havandat1523/IoT-Monitoring-System-for-Primary-Students-on-School-Shuttle-Buses/Altium_design/PCB_node3_iot.png

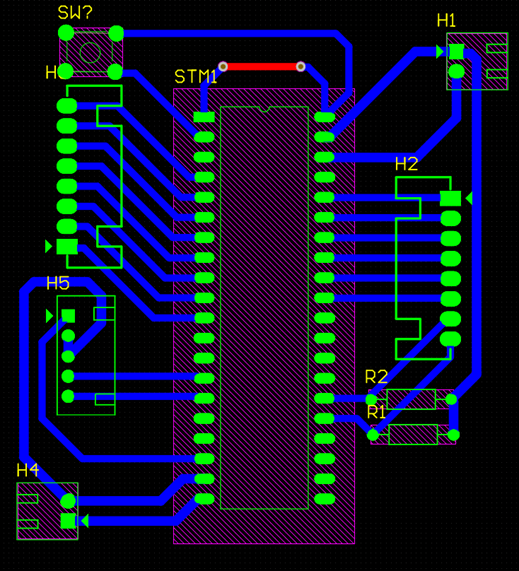
Altium_design/PCB_node3_iot.png
