havandat1523/IoT-Monitoring-System-for-Primary-Students-on-School-Shuttle-Buses/Altium_design/real_hardware_node3_iot.jpg

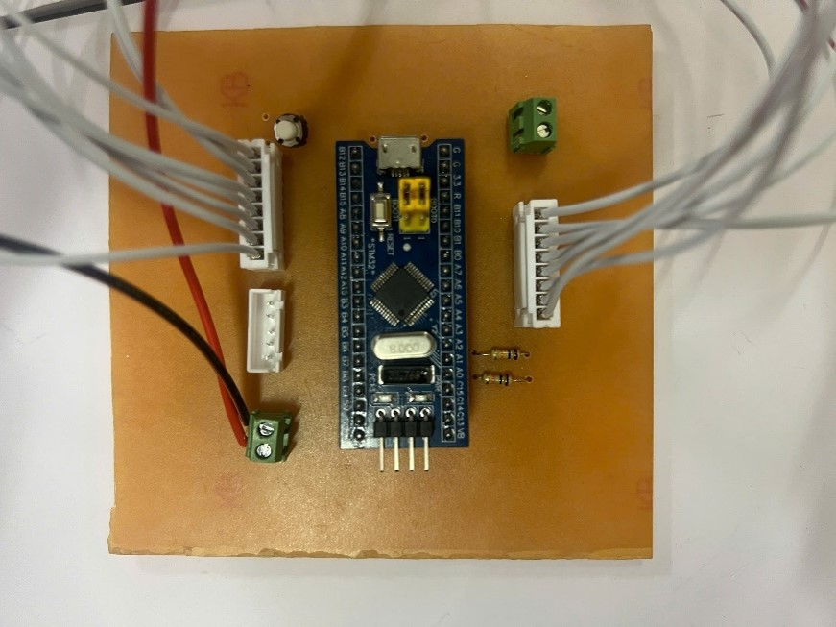
Altium_design/real_hardware_node3_iot.jpg
