havandat1523/IoT-Monitoring-System-for-Primary-Students-on-School-Shuttle-Buses/Altium_design/Schematic_node3_iot.png

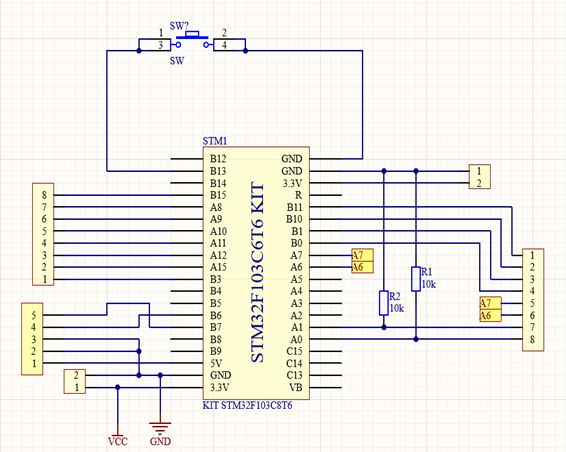
Altium_design/Schematic_node3_iot.png
