havandat1523/IoT-Monitoring-System-for-Primary-Students-on-School-Shuttle-Buses/CODE_App_Script/pictrure_1.png

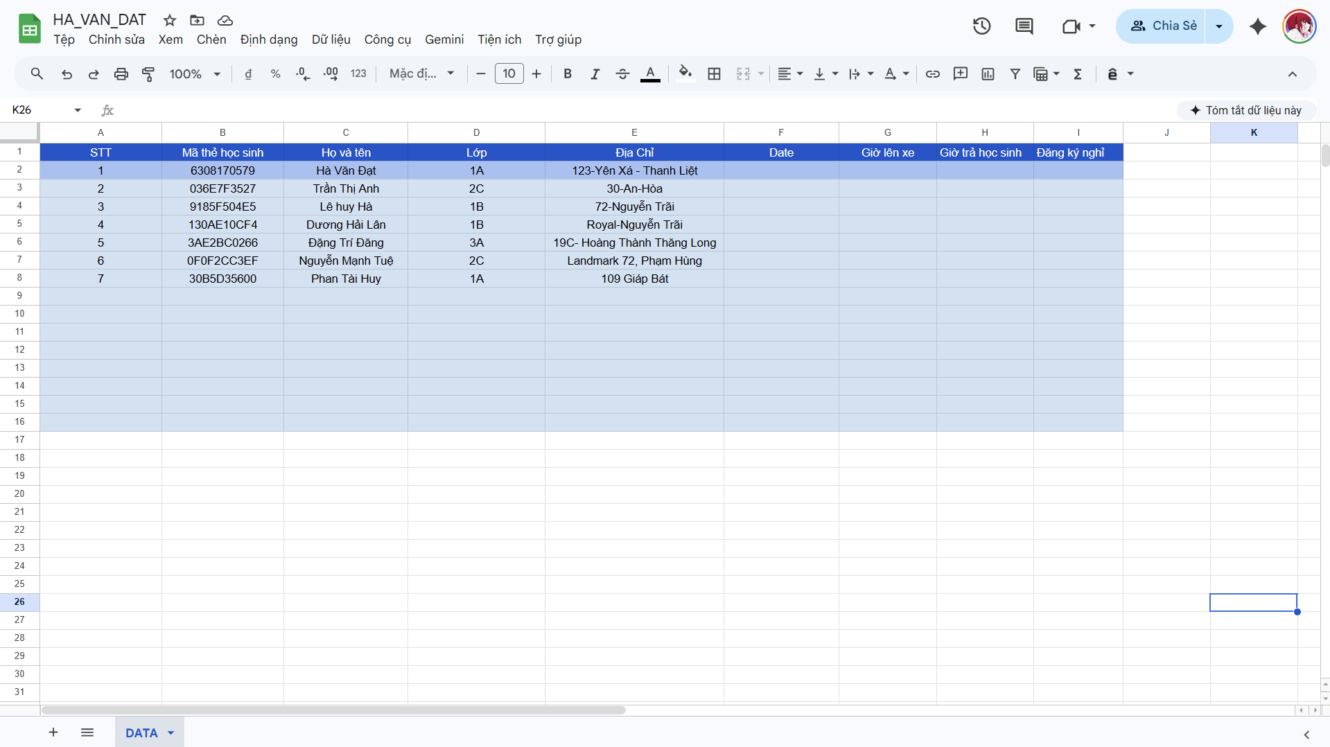
CODE_App_Script/pictrure_1.png
