havandat1523/IoT-Monitoring-System-for-Primary-Students-on-School-Shuttle-Buses/CODE_Thingsboard/3.png

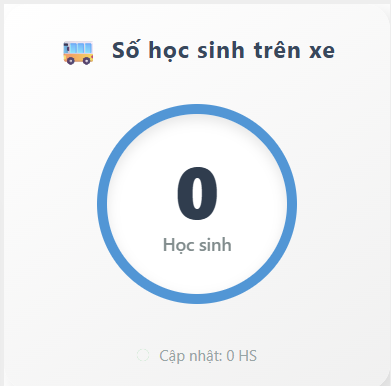
CODE_Thingsboard/3.png
