havandat1523/IoT-Monitoring-System-for-Primary-Students-on-School-Shuttle-Buses/CODE_Thingsboard/Ảnh chụp màn hình 2026-05-09 223746.png

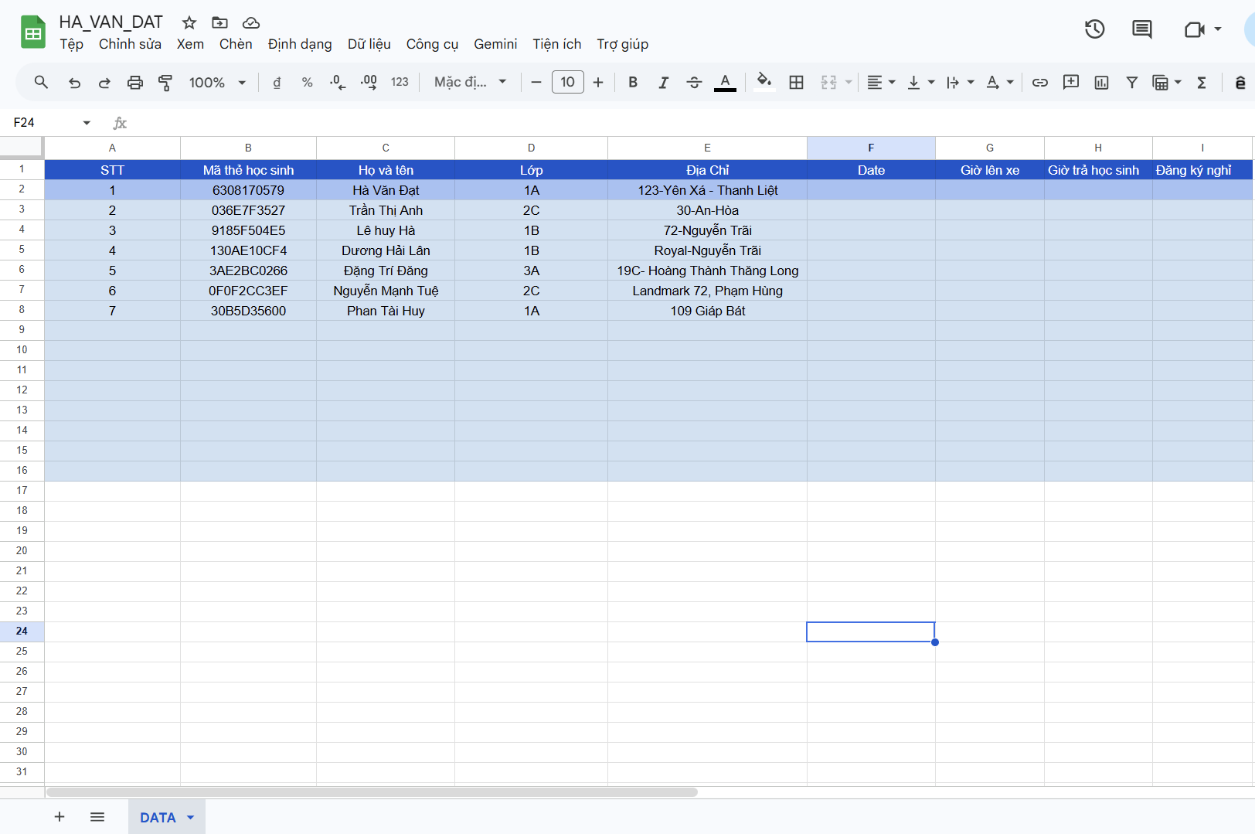
CODE_Thingsboard/Ảnh chụp màn hình 2026-05-09 223746.png
