havandat1523/IoT-Monitoring-System-for-Primary-Students-on-School-Shuttle-Buses/Altium_design/MASTER.pdf

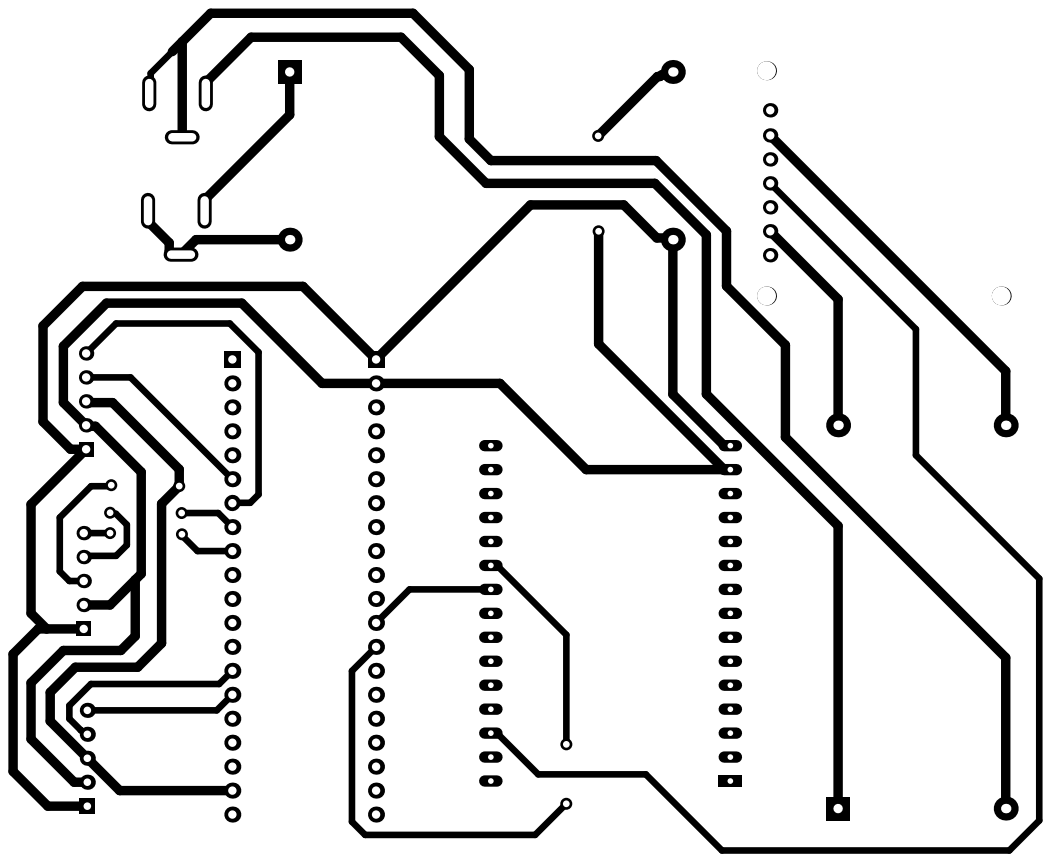
[picture p58: page 1]
