havandat1523/IoT-Monitoring-System-for-Primary-Students-on-School-Shuttle-Buses/Altium_design/NODE1_IOT.pdf

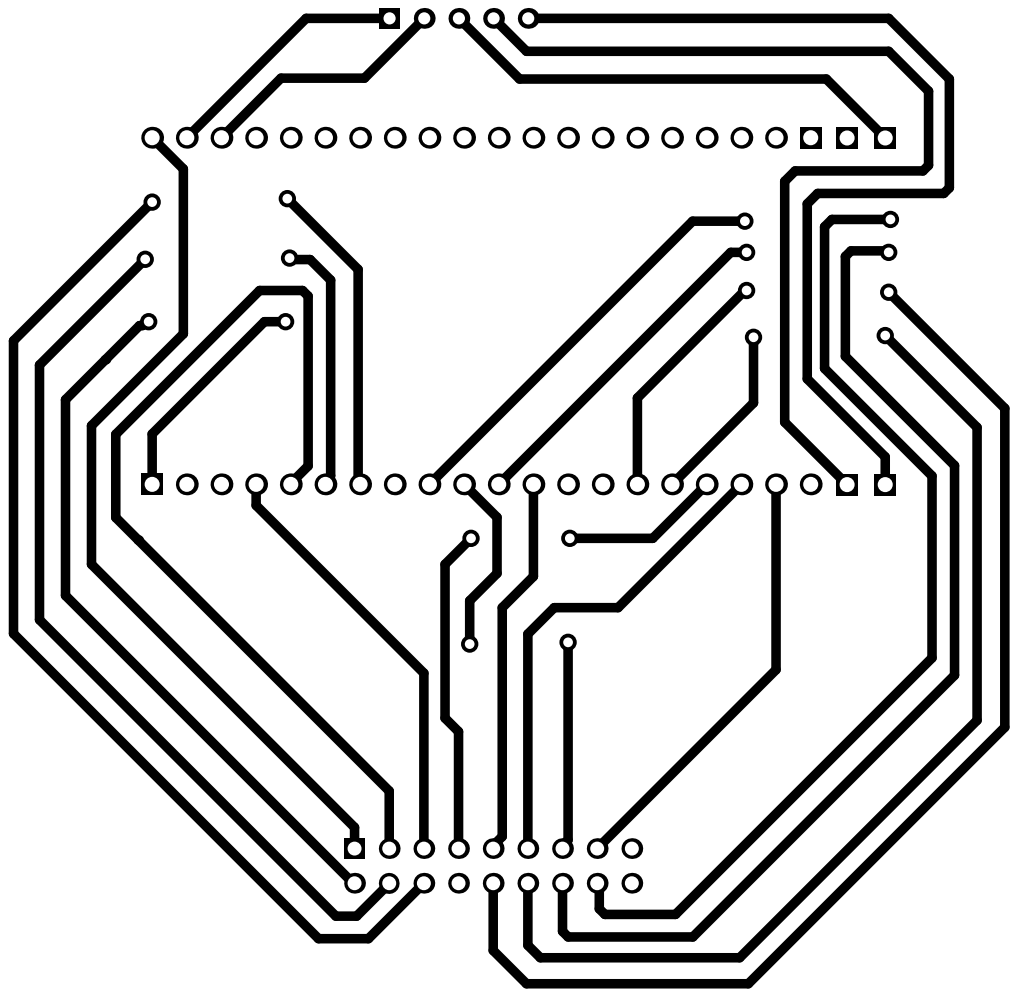
[picture p59: page 1]
