havandat1523/IoT-Monitoring-System-for-Primary-Students-on-School-Shuttle-Buses/Altium_design/NODE2_IOT.pdf

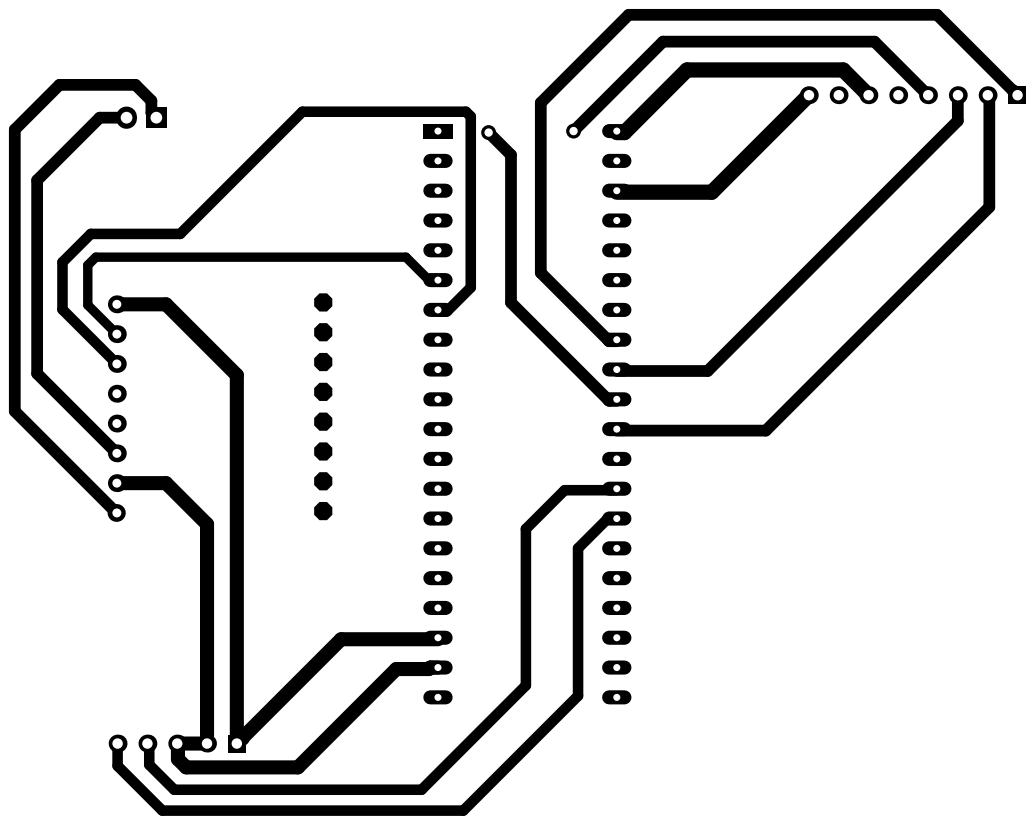
[picture p60: page 1]
