havandat1523/IoT-Monitoring-System-for-Primary-Students-on-School-Shuttle-Buses/Altium_design/NODE3_IOT.pdf

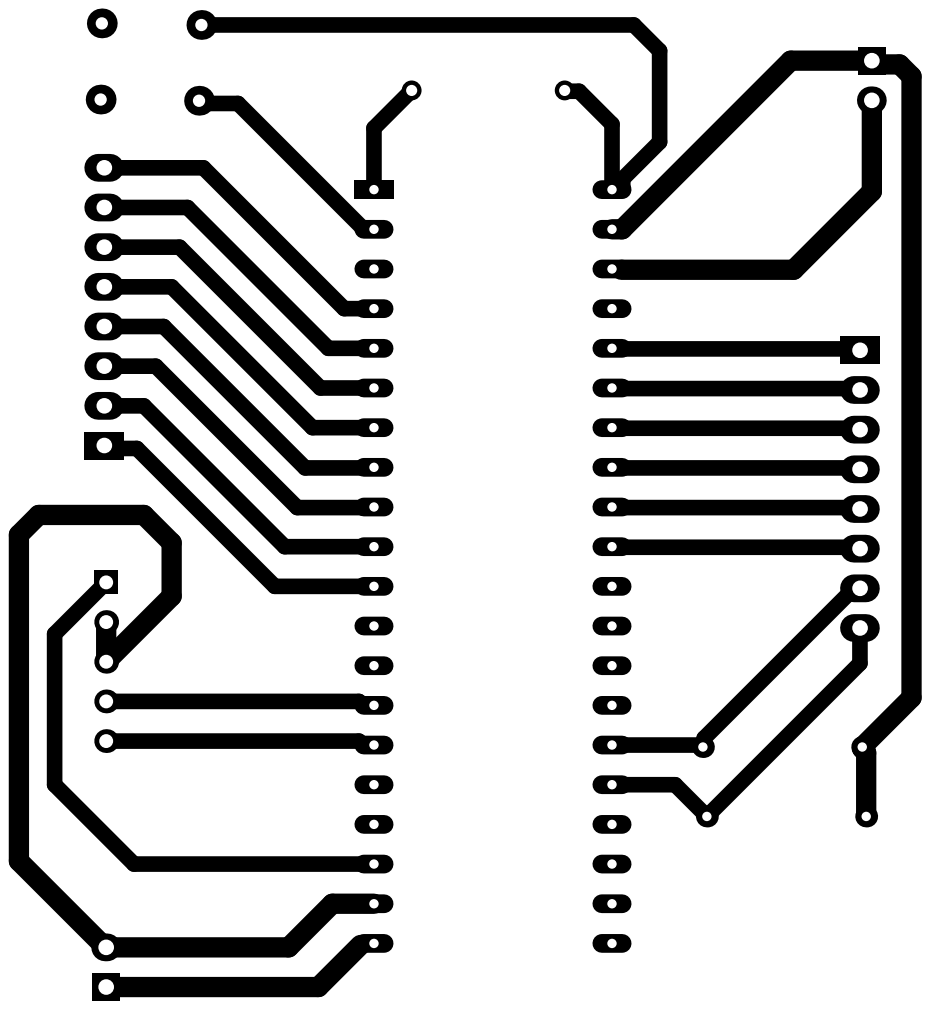
[picture p61: page 1]
