havandat1523/IoT-Monitoring-System-for-Primary-Students-on-School-Shuttle-Buses/CODE_NODE3/Core/Src/main.c

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
/* Includes ------------------------------------------------------------------*/
#include "main.h"

I2C_HandleTypeDef hi2c1;

TIM_HandleTypeDef htim2;

void SystemClock_Config(void);
static void MX_GPIO_Init(void);
static void MX_I2C1_Init(void);
static void MX_TIM2_Init(void);
/* USER CODE BEGIN 0 */
#define F411_I2C_ADDR  (0x20<<1) // Bắt buộc phải dịch trái 1 bit
/* USER CODE BEGIN 0 */
uint8_t int_Tem   = 0 ;
uint8_t float_Tem = 0 ;
uint8_t int_Hum   = 0 ;
uint8_t float_Hum = 0 ;
uint8_t CheckSum  = 0 ;


typedef struct {
    uint8_t physical_state;
    uint8_t confirmed_state;
    uint32_t last_time;
    uint8_t zero_count; // ← THÊM BỘ ĐẾM SỐ LẦN LIÊN TIẾP ĐỌC = 0
} Seat_t;

Seat_t seats[15]; // Mảng quản lý 14 cái ghế (12 nút nhấn + 2 ADC)
uint8_t flag_send_i2c = 0;   // Cờ báo hiệu cần gửi data lên F411
uint16_t all_seats_data = 0; // Biến 2 byte gom trạng thái các ghế

typedef struct {
    GPIO_TypeDef* port;
    uint16_t pin;
} Seat_Pin_Map_t;

// Đã đếm chuẩn 12 phần tử (Từ index 0 đến 11)
const Seat_Pin_Map_t SeatPins[15] = {
		{GPIOB,GPIO_PIN_11},//5 0
		{GPIOB,GPIO_PIN_1},  //1
		{GPIOB,GPIO_PIN_10},//0  2
		{GPIOB,GPIO_PIN_0},//7   3
		{GPIOA,GPIO_PIN_7},//9  4
		{GPIOA,GPIO_PIN_6},//8  5
		{GPIOA,GPIO_PIN_1},//11  6
		{GPIOA,GPIO_PIN_0},//10  7
		{GPIOB,GPIO_PIN_15},  //8
		{GPIOA,GPIO_PIN_8},//1  //9
		{GPIOA,GPIO_PIN_9},//2  10
		{GPIOA,GPIO_PIN_10},//4  11
		{GPIOC,GPIO_PIN_13},//12   12
		{GPIOC,GPIO_PIN_13},      //13
		{GPIOC,GPIO_PIN_13},//4  14


//		{GPIOB,GPIO_PIN_10},//0
//		{GPIOA,GPIO_PIN_8},//1
//		{GPIOA,GPIO_PIN_9},//2
//		{GPIOA,GPIO_PIN_10},//3
//		{GPIOA,GPIO_PIN_11},//4
//		//{GPIOA,GPIO_PIN_12},//5
//
//		//{GPIOB,GPIO_PIN_3},//7
//		{GPIOB,GPIO_PIN_13},//6
//		{GPIOB,GPIO_PIN_0},//7
//		{GPIOA,GPIO_PIN_6},//8
//		{GPIOA,GPIO_PIN_7},//9
//		{GPIOA,GPIO_PIN_0},//10
//		{GPIOA,GPIO_PIN_1},//11
//		{GPIOA,GPIO_PIN_15},//12
};

uint8_t Read_Seat_Hardware(uint8_t index) {
    // Chỉ đọc GPIO cho 12 ghế đầu tiên để tránh tràn mảng SeatPins
    if (index < 15) {
    	GPIO_TypeDef* current_port = SeatPins[index].port;
    	uint16_t current_pin = SeatPins[index].pin;
    	if (HAL_GPIO_ReadPin(current_port, current_pin) == GPIO_PIN_SET){
    		HAL_Delay(50);
    		return 1;
    	}
    	else if (HAL_GPIO_ReadPin(current_port, current_pin) == 0){
    		HAL_Delay(50);
    		return 0;
    	}
    }
    return 0;
}

//void Scan_All_Seats(void) {
//    // Quét đúng 15 ghế
//    for (int i = 0; i < 15; i++) {
//        uint8_t current_sensor = Read_Seat_Hardware(i);
//
//        if (current_sensor != seats[i].physical_state) {
//            // Trạng thái vật lý thay đổi -> cập nhật và reset mốc thời gian
//            seats[i].physical_state = current_sensor;
//            seats[i].last_time = HAL_GetTick();
//        }
//        else {
//            // Trạng thái vật lý đang giữ nguyên liên tục
//            uint32_t delay_thoi_gian;
//
//            // --- THIẾT LẬP THỜI GIAN CHỜ BẤT ĐỐI XỨNG ---
//            if (current_sensor == 1) {
//                // Người mới ngồi xuống: Chỉ cần giữ 0.5 giây là xác nhận có người
//                delay_thoi_gian = 1000;
//            } else {
//                // Người đứng lên (hoặc cảm biến tự ngắt): Chờ hẳn 3 giây mới xác nhận ghế trống
//                // Nếu trong 3 giây này tín hiệu bật lại mức 1, nó sẽ reset lại quá trình đếm
//                delay_thoi_gian = 30000;
//            }
//
//            // Nếu giữ trạng thái đủ thời gian yêu cầu
//            if (HAL_GetTick() - seats[i].last_time >= delay_thoi_gian) {
//
//                if (seats[i].confirmed_state != seats[i].physical_state) {
//                    seats[i].confirmed_state = seats[i].physical_state;
//
//                    if (seats[i].confirmed_state == 1) {
//                        all_seats_data |= (1 << i);  // Set bit lên 1 (Có người)
//                    } else {
//                        all_seats_data &= ~(1 << i); // Xóa bit về 0 (Trống)
//                    }
//
//                    flag_send_i2c = 1; // Bật cờ gửi data lên F4
//                }
//            }
//        }
//    }
//}
void Scan_All_Seats(void) {
    for (int i = 0; i < 15; i++) {
        uint8_t current_sensor = Read_Seat_Hardware(i);

        if (current_sensor != seats[i].physical_state) {
            // Trạng thái thay đổi → lưu lại và bắt đầu đếm 3 giây
            seats[i].physical_state = current_sensor;
            seats[i].last_time = HAL_GetTick();
        }
        else {
            // Giữ nguyên trạng thái → kiểm tra đủ 3 giây chưa
            if (HAL_GetTick() - seats[i].last_time >= 1000) {

                if (current_sensor == 1) {
                    // Giữ mức 1 đủ 3s → xác nhận có người
                    if (seats[i].confirmed_state != 1) {
                        seats[i].confirmed_state = 1;
                        all_seats_data |= (1 << i);
                        flag_send_i2c = 1;
                    }
                }
                else {
                    // Giữ mức 0 đủ 3s → xác nhận ghế trống
                    if (seats[i].confirmed_state != 0) {
                        seats[i].confirmed_state = 0;
                        all_seats_data &= ~(1 << i);
                        flag_send_i2c = 1;
                    }
                }
            }
        }
    }
}

uint8_t tx_buffer[4];
void xu_ly(uint16_t giatri){
	 // Tăng lên 3 byte
	tx_buffer[0] = 0x01;  // Gắn nhãn ID = 0x01 (Dữ liệu ghế)
	tx_buffer[1] = (giatri >> 8) & 0xFF; // Lấy byte cao
	tx_buffer[2] = giatri & 0xFF;        // Lấy byte thấp
	tx_buffer[3]= 0x09;
}
uint32_t doc = 0;
uint8_t trang_thai_cu = 1; // Trạng thái trước đó (mặc định nhả = 1)

void am_thanh(void) {
    uint8_t trang_thai_hien = HAL_GPIO_ReadPin(GPIOB, GPIO_PIN_13);

    // Phát hiện nhấn xuống (cạnh xuống: 1 → 0)
    if (trang_thai_hien == 0 && trang_thai_cu == 1) {
        doc = HAL_GetTick(); // Lưu thời điểm bắt đầu nhấn
    }

    // Kiểm tra giữ đủ 1 giây
    if (trang_thai_hien == 0 && (HAL_GetTick() - doc >= 500)) {
        // Xử lý ở đây
    	HAL_GPIO_TogglePin(GPIOB, GPIO_PIN_12);
        doc = HAL_GetTick(); // Reset để không gọi liên tục
    }

    trang_thai_cu = trang_thai_hien;
}
//uint8_t data = 23;
/* USER CODE END 0 */

/**
  * @brief  The application entry point.
  * @retval int
  */
int main(void)
{

  /* MCU Configuration--------------------------------------------------------*/

  /* Reset of all peripherals, Initializes the Flash interface and the Systick. */
  HAL_Init();

  /* Configure the system clock */
  SystemClock_Config();

  /* Initialize all configured peripherals */
  MX_GPIO_Init();
  MX_I2C1_Init();
  MX_TIM2_Init();
  /* USER CODE BEGIN 2 */
//  HAL_I2C_Master_Transmit(&hi2c1,(0x20<<1), &data, 1, 100);
  HAL_Delay(1000);
  HAL_StatusTypeDef trangthai;
  /* USER CODE END 2 */

  /* Infinite loop */
  /* USER CODE BEGIN WHILE */
  while (1)
  {
	 // HAL_Delay(2000);
    Scan_All_Seats();
    if (flag_send_i2c==1){

    	xu_ly(all_seats_data);
    	//HAL_Delay(20);
			trangthai = HAL_I2C_Master_Transmit(&hi2c1, F411_I2C_ADDR,(uint8_t*) &tx_buffer[0], 1, 1000);
			HAL_Delay(200);
			trangthai = HAL_I2C_Master_Transmit(&hi2c1, F411_I2C_ADDR,(uint8_t*) &tx_buffer[1], 1, 1000);
			HAL_Delay(200);
			trangthai = HAL_I2C_Master_Transmit(&hi2c1, F411_I2C_ADDR,(uint8_t*) &tx_buffer[2], 1, 1000);
			HAL_Delay(200);
			trangthai = HAL_I2C_Master_Transmit(&hi2c1, F411_I2C_ADDR,(uint8_t*) &tx_buffer[3], 1, 1000);
			flag_send_i2c =0;
    }
      am_thanh();

     	 HAL_Delay(200);


    /* USER CODE END WHILE */

    /* USER CODE BEGIN 3 */
  }
  /* USER CODE END 3 */
}

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
