havandat1523/IoT-Monitoring-System-for-Primary-Students-on-School-Shuttle-Buses/CODE_NODE_MASTER/STM32M/STM32M.ioc

Mcu.UserName=STM32F411CEUx
PA10.Signal=USART1_RX
PA11.Signal=USART6_TX
PA12.Signal=USART6_RX
PA13.Signal=SYS_JTMS-SWDIO
PA14.Signal=SYS_JTCK-SWCLK
PA2.Signal=USART2_TX
PA3.Signal=USART2_RX
PA9.Signal=USART1_TX
PB6.Signal=I2C1_SCL
PB7.Signal=I2C1_SDA
