havandat1523/IoT-Monitoring-System-for-Primary-Students-on-School-Shuttle-Buses/CODE_NODE2/Core/Src/main.c

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
/* Includes ------------------------------------------------------------------*/
#include "main.h"

/* USER CODE BEGIN Includes */
#include "RC522.h"
#include "DFPLAYER.h"
#include <string.h>
#include <stdio.h>

/* USER CODE END Includes */

/* USER CODE BEGIN PTD */
DFPLAYER_Name MP3;


/* USER CODE END PTD */

/* USER CODE BEGIN PD */
uint8_t u8_RxBuff1[50];  // Buffer cho UART1 (Camera)
uint8_t u8_RxBuff2[50];  // Buffer cho UART2 (ESP32)
uint8_t u8_RxBuff3[50];  // loa

uint8_t u8_RxData1;      // Byte nh?n c?a esp
uint8_t u8_RxData2;      // Byte nh?n c?a Camera
uint8_t u8_RxData3;      // Byte nhan cua loa

uint8_t _rxIndex1 = 0;   // Index cho UART1
uint8_t _rxIndex2 = 0;   // Index cho UART2
uint8_t _rxIndex3 = 0;   // Index cho UART3

volatile uint8_t Tx_Flag1 = 0; 
volatile uint8_t Tx_Flag2 = 0; 
volatile uint8_t Tx_Flag3 = 0;
/* USER CODE END PD */

SPI_HandleTypeDef hspi1;

UART_HandleTypeDef huart1;
UART_HandleTypeDef huart2;

/* USER CODE BEGIN PV */
uint8_t CardID[5];
uint8_t rx_data[3];
char tx_buffer[50];
//uint8_t ngat =0;

/* USER CODE END PV */

void SystemClock_Config(void);
static void MX_GPIO_Init(void);
static void MX_SPI1_Init(void);
static void MX_USART1_UART_Init(void);
static void MX_USART2_UART_Init(void);
/* USER CODE BEGIN 0 */
volatile uint8_t ngat = 0;

void HAL_UART_RxCpltCallback(UART_HandleTypeDef *huart)
{
    if(huart->Instance == USART2)
    {
        // Kiểm tra xem ký tự nhận được có phải là ký tự kết thúc (\r hoặc \n) không
        if(u8_RxData1 != '\r' && u8_RxData1 != '\n')
        {
            u8_RxBuff2[_rxIndex2++] = u8_RxData1; // Lưu vào buffer UART2
            if(_rxIndex2 >= sizeof(u8_RxBuff2) - 1) {
                _rxIndex2 = sizeof(u8_RxBuff2) - 1; // Chống tràn mảng
            }
        }
        else
        {
            if(_rxIndex2 > 0)
            {
                u8_RxBuff2[_rxIndex2] = '\0'; // Kết thúc chuỗi
                Tx_Flag2 = 1;                 // SỬA Ở ĐÂY: Set cờ UART2
            }
        }
        // Gọi lại ngắt nhận 1 byte tiếp theo
        HAL_UART_Receive_IT(&huart2, &u8_RxData1, 1);
    }
}
/* USER CODE END 0 */

/**
  * @brief  The application entry point.
  * @retval int
  */
int main(void)
{

  /* MCU Configuration--------------------------------------------------------*/

  /* Reset of all peripherals, Initializes the Flash interface and the Systick. */
  HAL_Init();

  /* Configure the system clock */
  SystemClock_Config();

  /* Initialize all configured peripherals */
  MX_GPIO_Init();
  MX_SPI1_Init();
  MX_USART1_UART_Init();
  MX_USART2_UART_Init();
  /* USER CODE BEGIN 2 */
	  TM_MFRC522_Init();
  DFPLAYER_Init(&MP3, &huart1);
  DFPLAYER_SetVolume(&MP3, 5);
	HAL_Delay(2000);
	DFPLAYER_PlayFileInFolder(&MP3, 02, 002);
  HAL_UART_Receive_IT(&huart2, &u8_RxData1, 1); 
  /* USER CODE END 2 */

  /* Infinite loop */
  /* USER CODE BEGIN WHILE */
  while (1)
  {
    /* USER CODE END WHILE */
   if (TM_MFRC522_Check(CardID) == MI_OK) {

              sprintf(tx_buffer, "%02X%02X%02X%02X%02X\r\n",
                      CardID[0], CardID[1], CardID[2], CardID[3], CardID[4]);
              HAL_UART_Transmit(&huart2, (uint8_t*)tx_buffer, strlen(tx_buffer), 1000);
              HAL_Delay(500);
      }
	    // XỬ LÝ NHẬN LỆNH TỪ UART2 ESP/MẠCH KHÁC
      if(Tx_Flag2 == 1)
      {
          // Dùng strcmp để so sánh toàn bộ chuỗi cho chính xác, thay vì so sánh từng ký tự
          if(strcmp((char*)u8_RxBuff2, "003") == 0) {
						// Nhận "003" thì phát loa bài 3 trong folder 3: h?c sinh cuoi cung da len xe bac tai có the di xe ve truong
              DFPLAYER_PlayFileInFolder(&MP3, 03, 003);
          }
          else if(strcmp((char*)u8_RxBuff2, "004") == 0) {
              // Nhận "004" thì phát loa bài 4 trong folder 4
              DFPLAYER_PlayFileInFolder(&MP3, 04, 004);
          }
					 
          else if(strcmp((char*)u8_RxBuff2, "001") == 0) {
              // hs dã xu?ng het xe bac tai kiem tra lai
              DFPLAYER_PlayFileInFolder(&MP3, 01, 001);
          }
					 else if(strcmp((char*)u8_RxBuff2, "005") == 0) {
              // Nhận "001" thì phát loa bài 01 trong folder 001
              DFPLAYER_PlayFileInFolder(&MP3, 05, 005);
          }
					 else if(strcmp((char*)u8_RxBuff2, "002") == 0) {
						 // Nhận "002" thì phát loa bài 002 trong folder 02: b?t dau khoi hanh
              DFPLAYER_PlayFileInFolder(&MP3, 02, 002);
          }
          
          // QUAN TRỌNG: Xóa cờ, reset Index và xóa bộ đệm để chờ nhận lệnh tiếp theo
          Tx_Flag2 = 0;
          _rxIndex2 = 0;
          memset(u8_RxBuff2, 0, sizeof(u8_RxBuff2));
      }

	 

    /* USER CODE BEGIN 3 */
  }
  /* USER CODE END 3 */
}

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
