havandat1523/IoT-Monitoring-System-for-Primary-Students-on-School-Shuttle-Buses/CODE_NODE2/Core/Src/RC522.c

/*
 * RC522.c
 *
 *  Created on: Mar 25, 2026
 *      Author: lanng
 */
#include "RC522.h"

// Gọi ra biến hspi2 đã được khởi tạo bên trong file main.c
extern SPI_HandleTypeDef hspi1;

// --- HÀM GIAO TIẾP SPI LÕI (Sử dụng HAL) ---
uint8_t TM_SPI_Send(uint8_t data) {
    uint8_t rx_data = 0;
    // Truyền 1 byte và nhận về 1 byte qua SPI2, timeout 100ms
    HAL_SPI_TransmitReceive(&hspi1, &data, &rx_data, 1, 100);
    return rx_data;
}

// --- QUẢN LÝ CHÂN CHIP SELECT (Software NSS) ---
void MFRC522_CS_LOW(void) {
	HAL_GPIO_WritePin(GPIOB, GPIO_PIN_0, GPIO_PIN_RESET);
}

void MFRC522_CS_HIGH(void) {
	HAL_GPIO_WritePin(GPIOB, GPIO_PIN_0, GPIO_PIN_SET);
}

// ==========================================================
// CÁC HÀM XỬ LÝ LOGIC CỦA RC522 (Giữ nguyên thuật toán gốc)
// ==========================================================

void TM_MFRC522_Init(void) {
	MFRC522_CS_HIGH(); // Đảm bảo CS ở mức cao trước khi bắt đầu

	TM_MFRC522_Reset();

	TM_MFRC522_WriteRegister(MFRC522_REG_T_MODE, 0x8D);
	TM_MFRC522_WriteRegister(MFRC522_REG_T_PRESCALER, 0x3E);
	TM_MFRC522_WriteRegister(MFRC522_REG_T_RELOAD_L, 30);
	TM_MFRC522_WriteRegister(MFRC522_REG_T_RELOAD_H, 0);

	/* 48dB gain */
	TM_MFRC522_WriteRegister(MFRC522_REG_RF_CFG, 0x70);

	TM_MFRC522_WriteRegister(MFRC522_REG_TX_AUTO, 0x40);
	TM_MFRC522_WriteRegister(MFRC522_REG_MODE, 0x3D);

	TM_MFRC522_AntennaOn();		//Open the antenna
}

TM_MFRC522_Status_t TM_MFRC522_Check(uint8_t* id) {
	TM_MFRC522_Status_t status;
	//Find cards, return card type
	status = TM_MFRC522_Request(PICC_REQIDL, id);
	if (status == MI_OK) {
		//Card detected
		//Anti-collision, return card serial number 4 bytes
		status = TM_MFRC522_Anticoll(id);
	}
	TM_MFRC522_Halt();			//Command card into hibernation

	return status;
}

TM_MFRC522_Status_t TM_MFRC522_Compare(uint8_t* CardID, uint8_t* CompareID) {
	uint8_t i;
	for (i = 0; i < 5; i++) {
		if (CardID[i] != CompareID[i]) {
			return MI_ERR;
		}
	}
	return MI_OK;
}

void TM_MFRC522_WriteRegister(uint8_t addr, uint8_t val) {
	//CS low
	MFRC522_CS_LOW();
	//Send address
	TM_SPI_Send((addr << 1) & 0x7E);
	//Send data
	TM_SPI_Send(val);
	//CS high
	MFRC522_CS_HIGH();
}

uint8_t TM_MFRC522_ReadRegister(uint8_t addr) {
	uint8_t val;
	//CS low
	MFRC522_CS_LOW();

	TM_SPI_Send(((addr << 1) & 0x7E) | 0x80);
	val = TM_SPI_Send(MFRC522_DUMMY);
	//CS high
	MFRC522_CS_HIGH();

	return val;
}

void TM_MFRC522_SetBitMask(uint8_t reg, uint8_t mask) {
	TM_MFRC522_WriteRegister(reg, TM_MFRC522_ReadRegister(reg) | mask);
}

void TM_MFRC522_ClearBitMask(uint8_t reg, uint8_t mask){
	TM_MFRC522_WriteRegister(reg, TM_MFRC522_ReadRegister(reg) & (~mask));
}

void TM_MFRC522_AntennaOn(void) {
	uint8_t temp;

	temp = TM_MFRC522_ReadRegister(MFRC522_REG_TX_CONTROL);
	if (!(temp & 0x03)) {
		TM_MFRC522_SetBitMask(MFRC522_REG_TX_CONTROL, 0x03);
	}
}

void TM_MFRC522_AntennaOff(void) {
	TM_MFRC522_ClearBitMask(MFRC522_REG_TX_CONTROL, 0x03);
}

void TM_MFRC522_Reset(void) {
	TM_MFRC522_WriteRegister(MFRC522_REG_COMMAND, PCD_RESETPHASE);
}

TM_MFRC522_Status_t TM_MFRC522_Request(uint8_t reqMode, uint8_t* TagType) {
	TM_MFRC522_Status_t status;
	uint16_t backBits;			//The received data bits

	TM_MFRC522_WriteRegister(MFRC522_REG_BIT_FRAMING, 0x07);		//TxLastBists = BitFramingReg[2..0]	???

	TagType[0] = reqMode;
	status = TM_MFRC522_ToCard(PCD_TRANSCEIVE, TagType, 1, TagType, &backBits);

	if ((status != MI_OK) || (backBits != 0x10)) {
		status = MI_ERR;
	}

	return status;
}

TM_MFRC522_Status_t TM_MFRC522_ToCard(uint8_t command, uint8_t* sendData, uint8_t sendLen, uint8_t* backData, uint16_t* backLen) {
	TM_MFRC522_Status_t status = MI_ERR;
	uint8_t irqEn = 0x00;
	uint8_t waitIRq = 0x00;
	uint8_t lastBits;
	uint8_t n;
	uint16_t i;

	switch (command) {
		case PCD_AUTHENT: {
			irqEn = 0x12;
			waitIRq = 0x10;
			break;
		}
		case PCD_TRANSCEIVE: {
			irqEn = 0x77;
			waitIRq = 0x30;
			break;
		}
		default:
			break;
	}

	TM_MFRC522_WriteRegister(MFRC522_REG_COMM_IE_N, irqEn | 0x80);
	TM_MFRC522_ClearBitMask(MFRC522_REG_COMM_IRQ, 0x80);
	TM_MFRC522_SetBitMask(MFRC522_REG_FIFO_LEVEL, 0x80);

	TM_MFRC522_WriteRegister(MFRC522_REG_COMMAND, PCD_IDLE);

	//Writing data to the FIFO
	for (i = 0; i < sendLen; i++) {
		TM_MFRC522_WriteRegister(MFRC522_REG_FIFO_DATA, sendData[i]);
	}

	//Execute the command
	TM_MFRC522_WriteRegister(MFRC522_REG_COMMAND, command);
	if (command == PCD_TRANSCEIVE) {
		TM_MFRC522_SetBitMask(MFRC522_REG_BIT_FRAMING, 0x80);		//StartSend=1,transmission of data starts
	}

	//Waiting to receive data to complete
	i = 2000;	//i according to the clock frequency adjustment, the operator M1 card maximum waiting time 25ms???
	do {
		//CommIrqReg[7..0]
		//Set1 TxIRq RxIRq IdleIRq HiAlerIRq LoAlertIRq ErrIRq TimerIRq
		n = TM_MFRC522_ReadRegister(MFRC522_REG_COMM_IRQ);
		i--;
	} while ((i!=0) && !(n&0x01) && !(n&waitIRq));

	TM_MFRC522_ClearBitMask(MFRC522_REG_BIT_FRAMING, 0x80);			//StartSend=0

	if (i != 0)  {
		if (!(TM_MFRC522_ReadRegister(MFRC522_REG_ERROR) & 0x1B)) {
			status = MI_OK;
			if (n & irqEn & 0x01) {
				status = MI_NOTAGERR;
			}

			if (command == PCD_TRANSCEIVE) {
				n = TM_MFRC522_ReadRegister(MFRC522_REG_FIFO_LEVEL);
				lastBits = TM_MFRC522_ReadRegister(MFRC522_REG_CONTROL) & 0x07;
				if (lastBits) {
					*backLen = (n - 1) * 8 + lastBits;
				} else {
					*backLen = n * 8;
				}

				if (n == 0) {
					n = 1;
				}
				if (n > MFRC522_MAX_LEN) {
					n = MFRC522_MAX_LEN;
				}

				//Reading the received data in FIFO
				for (i = 0; i < n; i++) {
					backData[i] = TM_MFRC522_ReadRegister(MFRC522_REG_FIFO_DATA);
				}
			}
		} else {
			status = MI_ERR;
		}
	}

	return status;
}

TM_MFRC522_Status_t TM_MFRC522_Anticoll(uint8_t* serNum) {
	TM_MFRC522_Status_t status;
	uint8_t i;
	uint8_t serNumCheck = 0;
	uint16_t unLen;

	TM_MFRC522_WriteRegister(MFRC522_REG_BIT_FRAMING, 0x00);		//TxLastBists = BitFramingReg[2..0]

	serNum[0] = PICC_ANTICOLL;
	serNum[1] = 0x20;
	status = TM_MFRC522_ToCard(PCD_TRANSCEIVE, serNum, 2, serNum, &unLen);

	if (status == MI_OK) {
		//Check card serial number
		for (i = 0; i < 4; i++) {
			serNumCheck ^= serNum[i];
		}
		if (serNumCheck != serNum[i]) {
			status = MI_ERR;
		}
	}
	return status;
}

void TM_MFRC522_CalculateCRC(uint8_t* pIndata, uint8_t len, uint8_t* pOutData) {
	uint8_t i, n;

	TM_MFRC522_ClearBitMask(MFRC522_REG_DIV_IRQ, 0x04);			//CRCIrq = 0
	TM_MFRC522_SetBitMask(MFRC522_REG_FIFO_LEVEL, 0x80);			//Clear the FIFO pointer

	//Writing data to the FIFO
	for (i = 0; i < len; i++) {
		TM_MFRC522_WriteRegister(MFRC522_REG_FIFO_DATA, *(pIndata+i));
	}
	TM_MFRC522_WriteRegister(MFRC522_REG_COMMAND, PCD_CALCCRC);

	//Wait CRC calculation is complete
	i = 0xFF;
	do {
		n = TM_MFRC522_ReadRegister(MFRC522_REG_DIV_IRQ);
		i--;
	} while ((i!=0) && !(n&0x04));			//CRCIrq = 1

	//Read CRC calculation result
	pOutData[0] = TM_MFRC522_ReadRegister(MFRC522_REG_CRC_RESULT_L);
	pOutData[1] = TM_MFRC522_ReadRegister(MFRC522_REG_CRC_RESULT_M);
}

uint8_t TM_MFRC522_SelectTag(uint8_t* serNum) {
	uint8_t i;
	TM_MFRC522_Status_t status;
	uint8_t size;
	uint16_t recvBits;
	uint8_t buffer[9];

	buffer[0] = PICC_SElECTTAG;
	buffer[1] = 0x70;
	for (i = 0; i < 5; i++) {
		buffer[i+2] = *(serNum+i);
	}
	TM_MFRC522_CalculateCRC(buffer, 7, &buffer[7]);		//??
	status = TM_MFRC522_ToCard(PCD_TRANSCEIVE, buffer, 9, buffer, &recvBits);

	if ((status == MI_OK) && (recvBits == 0x18)) {
		size = buffer[0];
	} else {
		size = 0;
	}

	return size;
}

TM_MFRC522_Status_t TM_MFRC522_Auth(uint8_t authMode, uint8_t BlockAddr, uint8_t* Sectorkey, uint8_t* serNum) {
	TM_MFRC522_Status_t status;
	uint16_t recvBits;
	uint8_t i;
	uint8_t buff[12];

	//Verify the command block address + sector + password + card serial number
	buff[0] = authMode;
	buff[1] = BlockAddr;
	for (i = 0; i < 6; i++) {
		buff[i+2] = *(Sectorkey+i);
	}
	for (i=0; i<4; i++) {
		buff[i+8] = *(serNum+i);
	}
	status = TM_MFRC522_ToCard(PCD_AUTHENT, buff, 12, buff, &recvBits);

	if ((status != MI_OK) || (!(TM_MFRC522_ReadRegister(MFRC522_REG_STATUS2) & 0x08))) {
		status = MI_ERR;
	}

	return status;
}

TM_MFRC522_Status_t TM_MFRC522_Read(uint8_t blockAddr, uint8_t* recvData) {
	TM_MFRC522_Status_t status;
	uint16_t unLen;

	recvData[0] = PICC_READ;
	recvData[1] = blockAddr;
	TM_MFRC522_CalculateCRC(recvData,2, &recvData[2]);
	status = TM_MFRC522_ToCard(PCD_TRANSCEIVE, recvData, 4, recvData, &unLen);

	if ((status != MI_OK) || (unLen != 0x90)) {
		status = MI_ERR;
	}

	return status;
}

TM_MFRC522_Status_t TM_MFRC522_Write(uint8_t blockAddr, uint8_t* writeData) {
	TM_MFRC522_Status_t status;
	uint16_t recvBits;
	uint8_t i;
	uint8_t buff[18];

	buff[0] = PICC_WRITE;
	buff[1] = blockAddr;
	TM_MFRC522_CalculateCRC(buff, 2, &buff[2]);
	status = TM_MFRC522_ToCard(PCD_TRANSCEIVE, buff, 4, buff, &recvBits);

	if ((status != MI_OK) || (recvBits != 4) || ((buff[0] & 0x0F) != 0x0A)) {
		status = MI_ERR;
	}

	if (status == MI_OK) {
		//Data to the FIFO write 16Byte
		for (i = 0; i < 16; i++) {
			buff[i] = *(writeData+i);
		}
		TM_MFRC522_CalculateCRC(buff, 16, &buff[16]);
		status = TM_MFRC522_ToCard(PCD_TRANSCEIVE, buff, 18, buff, &recvBits);

		if ((status != MI_OK) || (recvBits != 4) || ((buff[0] & 0x0F) != 0x0A)) {
			status = MI_ERR;
		}
	}

	return status;
}

void TM_MFRC522_Halt(void) {
	uint16_t unLen;
	uint8_t buff[4];

	buff[0] = PICC_HALT;
	buff[1] = 0;
	TM_MFRC522_CalculateCRC(buff, 2, &buff[2]);

	TM_MFRC522_ToCard(PCD_TRANSCEIVE, buff, 4, buff, &unLen);
}
