havandat1523/IoT-Monitoring-System-for-Primary-Students-on-School-Shuttle-Buses/(notices)

Notices in the files:
CODE_NODE2/Core/Src/main.c:
Copyright (c) 2026 STMicroelectronics.
All rights reserved.
This software is licensed under terms that can be found in the LICENSE file
